jessee3/function_generator_scope_board/README.md

## 3D View
