jessee3/function_generator_scope_board/Mixed Signal Oscilloscope and Signal Generator Board.kicad_pcb

## KiCad design Mixed Signal Oscilloscope and Signal Generator Board.kicad_pcb (2025-03-13)

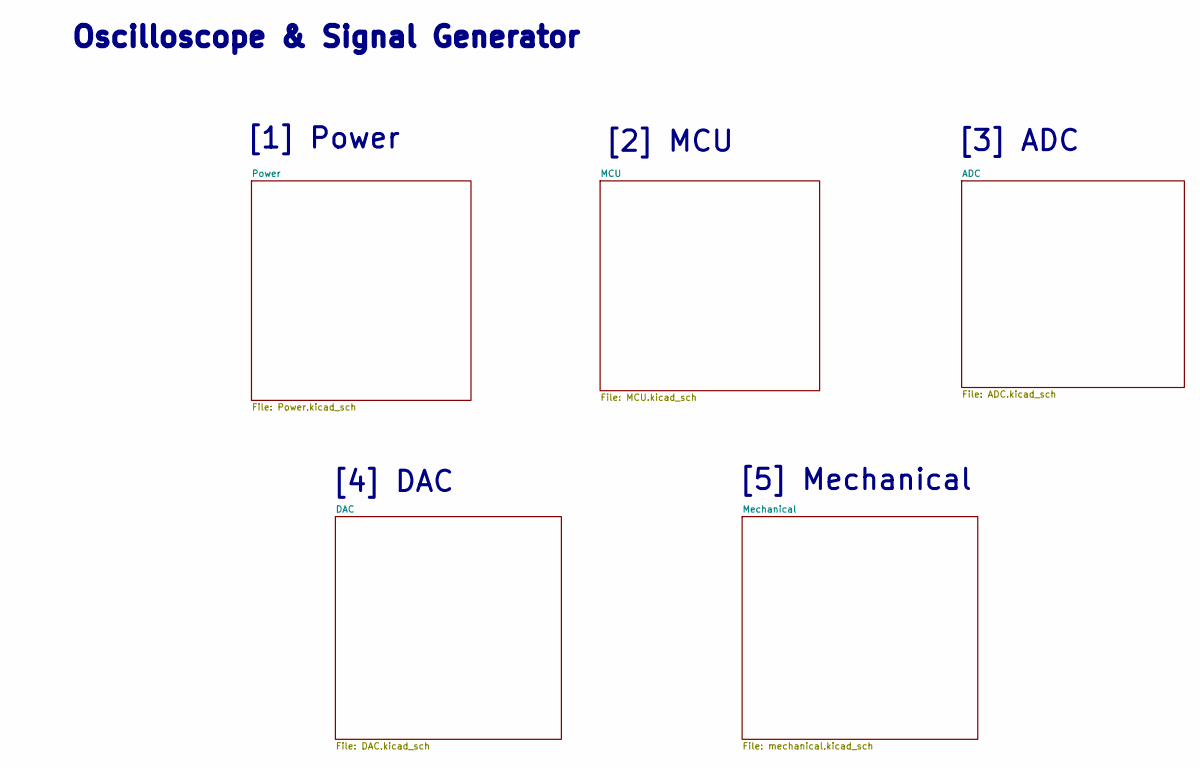
[picture p1: schematic Mixed Signal Oscilloscope and Signal Generator Board.kicad_sch, Oscilloscope & Signal Generator]

Notes on the sheet:
[1] Power
[3] ADC
Oscilloscope & Signal Generator
[4] DAC
[2] MCU
[5] Mechanical

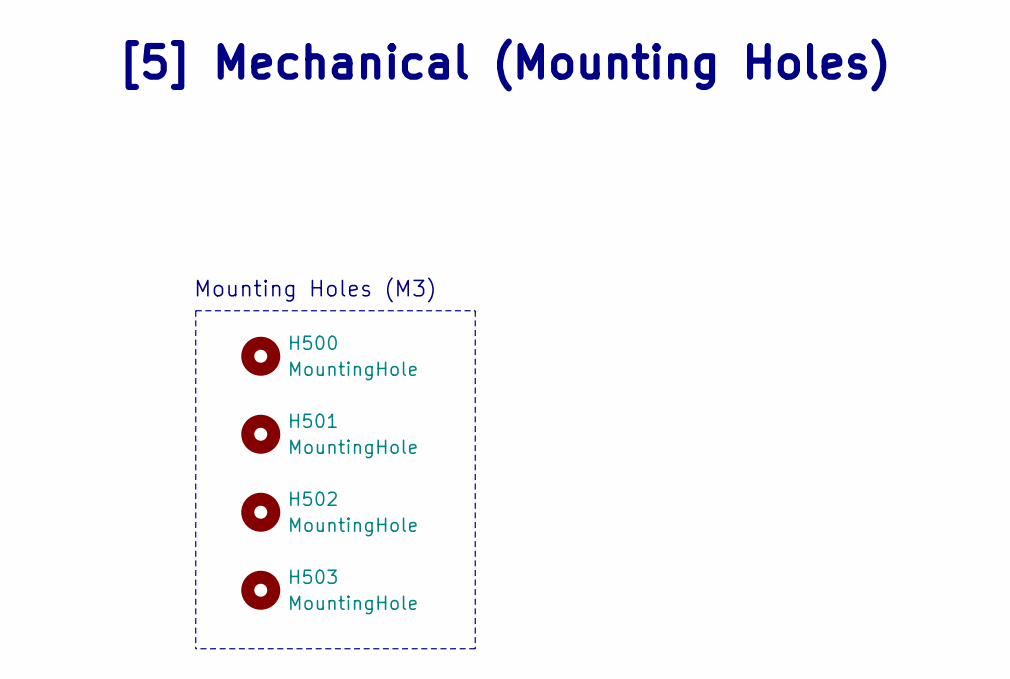
[picture p2: schematic mechanical.kicad_sch]

Parts:
H500, H501, H502, H503: MountingHole; MountingHole_3.2mm_M3

Notes on the sheet:
Mounting Holes (M3)
[5] Mechanical (Mounting Holes)

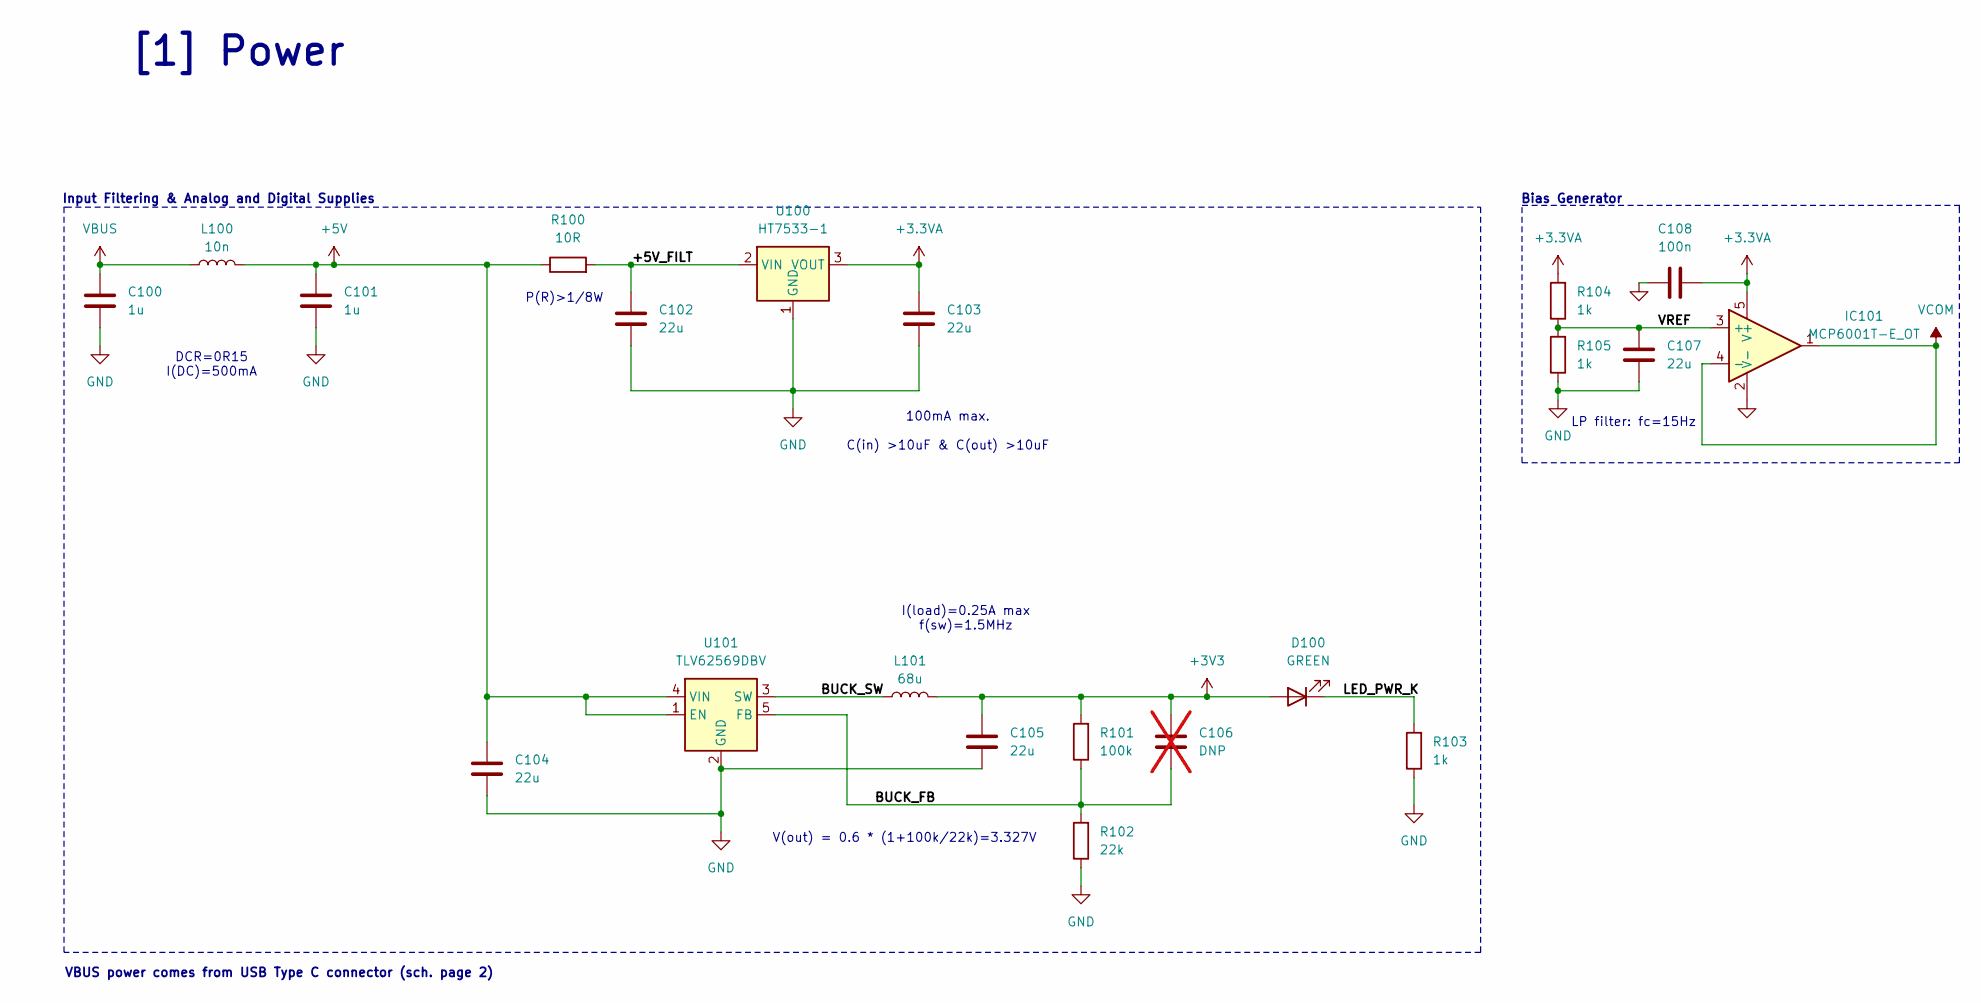
[picture p3: schematic Power.kicad_sch, Oscilloscope & Signal Generator]

Parts:
C100, C101: 1u; C_0603_1608Metric; Manufacturer_Part_Number CL10A105KO8NNNC; LCSC Part Number C1592
C102, C103, C104, C105, C107: 22u; C_0805_2012Metric; Manufacturer_Part_Number CL21A226MAQNNNE; LCSC Part Number C45783
C106: DNP; C_0402_1005Metric; not fitted
C108: 100n; C_0402_1005Metric; Manufacturer_Part_Number CL05B104KO5NNNC; LCSC Part Number C1525
D100: GREEN; LED_0603_1608Metric; Manufacturer_Part_Number LTST-C191KGKT; LCSC Part Number C125098
IC101: MCP6001T-E_OT; SOT95P270X145-5N; Manufacturer_Part_Number MCP6001T-E/OT; LCSC Part Number C29429
L100: 10n; L_0402_1005Metric; Manufacturer_Part_Number LQG15HS10NJ02D; LCSC Part Number C77103
L101: 68u; MWSA0603S; Manufacturer_Part_Number MWSA0603S-100MT
R100: 10R; R_0805_2012Metric; Manufacturer_Part_Number RC0805FR-0710RL; LCSC Part Number C96347
R101: 100k; R_0402_1005Metric; Manufacturer_Part_Number RC0402FR-07100KL; LCSC Part Number C60491
R102: 22k; R_0402_1005Metric; Manufacturer_Part_Number AECR0402F22K0K9; LCSC Part Number C328311
R103, R104, R105: 1k; R_0402_1005Metric; Manufacturer_Part_Number RC0402FR-071KL; LCSC Part Number C106235
U100: HT7533-1; SOT-89-3; Manufacturer_Part_Number HT7533-1; LCSC Part Number C5451672
U101: TLV62569DBV; SOT-23-5; Manufacturer_Part_Number TLV62569DBVR; LCSC Part Number C141836

Connections:
+3.3VA: C103.1, C108.2, IC101.5 (V+), R104.2, U100.3 (VOUT); also elsewhere on the board
+3V3: C105.1, C106.1, D100.2 (A), L101.2, R101.2; also elsewhere on the board
+5V: C101.1, C104.1, L100.2, R100.1, U101.1 (EN), U101.4 (VIN); also elsewhere on the board
/Power/+5V_FILT: C102.1, R100.2, U100.2 (VIN)
/Power/BUCK_FB: C106.2, R101.1, R102.2, U101.5 (FB)
/Power/BUCK_SW: L101.1, U101.3 (SW)
/Power/LED_PWR_K: D100.1 (K), R103.2
/Power/VREF: C107.1, IC101.3 (+), R104.1, R105.2
GND: C100.2, C101.2, C102.2, C103.2, C104.2, C105.2, C107.2, C108.1, IC101.2 (V-), R102.1, R103.1, R105.1, U100.1 (GND), U101.2 (GND); also elsewhere on the board
VBUS: C100.1, L100.1; also elsewhere on the board
VCOM: IC101.1, IC101.4 (-); also elsewhere on the board

Notes on the sheet:
Bias Generator
V(out) = 0.6 * (1+100k/22k)=3.327V
P(R)>1/8W
100mA max. C(in) >10uF & C(out) >10uF
Input Filtering & Analog and Digital Supplies
VBUS power comes from USB Type C connector (sch. page 2)
DCR=0R15 I(DC)=500mA
I(load)=0.25A max f(sw)=1.5MHz
LP filter: fc=15Hz
[1] Power

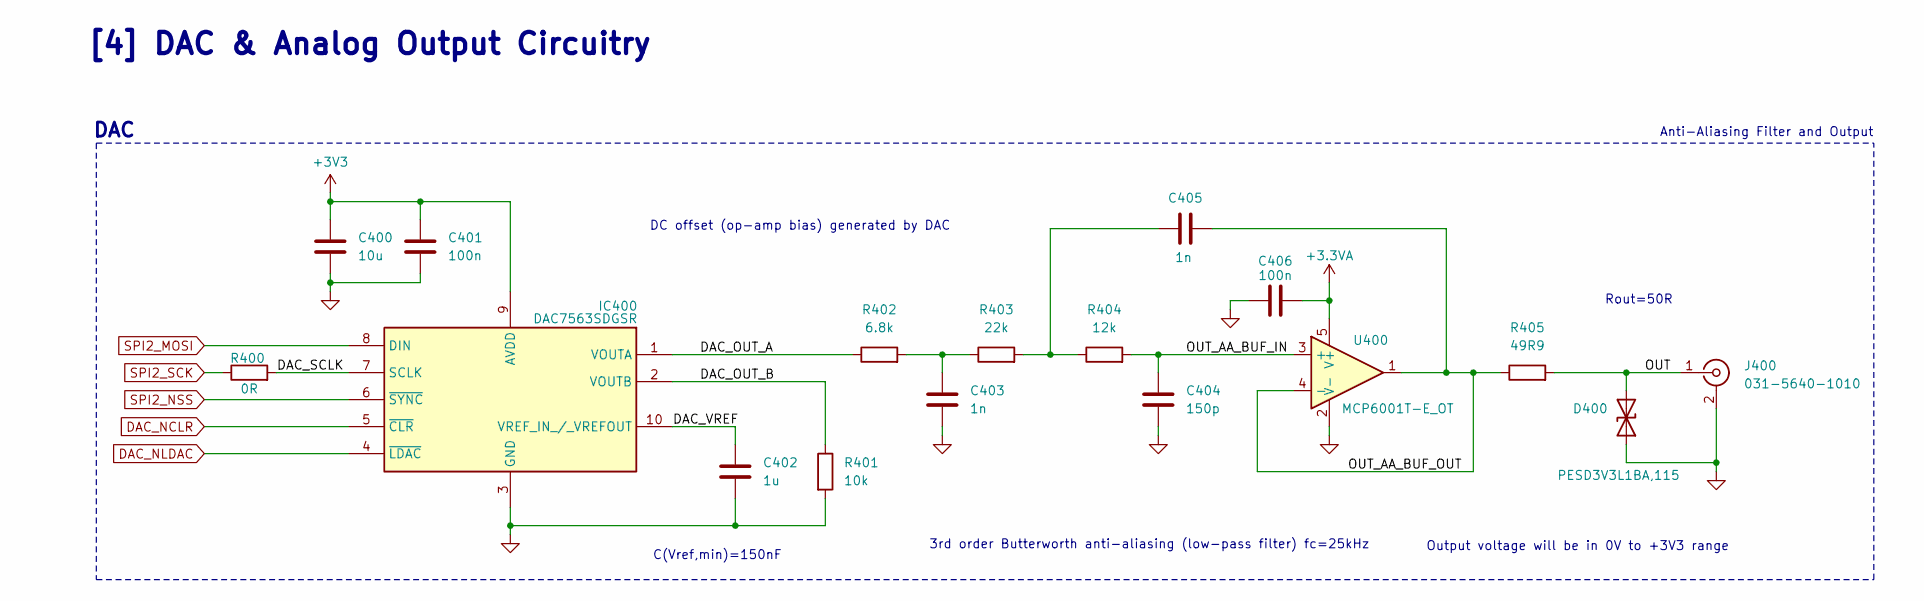
[picture p4: schematic DAC.kicad_sch, Oscilloscope & Signal Generator]

Parts:
C400: 10u; C_0603_1608Metric; Manufacturer_Part_Number CL10A106MQ8NNNC; LCSC Part Number C1691
C401, C406: 100n; C_0402_1005Metric; Manufacturer_Part_Number CL05B104KO5NNNC; LCSC Part Number C1525
C402: 1u; C_0603_1608Metric; Manufacturer_Part_Number CL10A105KO8NNNC; LCSC Part Number C1592
C403, C405: 1n; C_0402_1005Metric; Manufacturer_Part_Number CL05B102KB5NNNC; LCSC Part Number C14442
C404: 150p; C_0402_1005Metric; Manufacturer_Part_Number CL05C151JB51PNC; LCSC Part Number C472448
D400: PESD3V3L1BA,115; SOD2512X110N; Manufacturer_Part_Number PESD3V3L1BA,115; LCSC Part Number C51450
IC400: DAC7563SDGSR; SOP50P490X110-10N; Manufacturer_Part_Number DAC7563SDGSR; LCSC Part Number C601656
J400: 031-5640-1010; AMPHENOL-BNC-031-5640-1010; Manufacturer_Part_Number 31-5640-1010; LCSC Part Number C6997605
R400: 0R; R_0402_1005Metric; Manufacturer_Part_Number RC0402FR-070RL; LCSC Part Number C106231
R401: 10k; R_0402_1005Metric; Manufacturer_Part_Number RC0402FR-0710KL; LCSC Part Number C60490
R402: 6.8k; R_0402_1005Metric; Manufacturer_Part_Number RC0402JR-076K8L; LCSC Part Number C137847
R403: 22k; R_0402_1005Metric; Manufacturer_Part_Number AECR0402F22K0K9; LCSC Part Number C328311
R404: 12k; R_0402_1005Metric; Manufacturer_Part_Number FRC0402J123 TS; LCSC Part Number C2906889
R405: 49R9; R_0402_1005Metric; Manufacturer_Part_Number RC0402FR-0749R9L; LCSC Part Number C87044
U400: MCP6001T-E_OT; SOT95P270X145-5N; Manufacturer_Part_Number MCP6001T-E/OT; LCSC Part Number C29429

Connections:
+3.3VA: C406.2, U400.5 (V+); also elsewhere on the board
+3V3: C400.1, C401.1, IC400.9 (AVDD); also elsewhere on the board
/DAC/DAC_OUT_A: IC400.1 (VOUTA), R402.1
/DAC/DAC_OUT_B: IC400.2 (VOUTB), R401.1
/DAC/DAC_SCLK: IC400.7 (SCLK), R400.2
/DAC/DAC_VREF: C402.1, IC400.10 (VREF_IN_/_VREFOUT)
/DAC/OUT: D400.2 (A2), J400.1 (In), R405.2
/DAC/OUT_AA_BUF_IN: C404.1, R404.2, U400.3 (+)
/DAC/OUT_AA_BUF_OUT: C405.2, R405.1, U400.1, U400.4 (-)
DAC_NCLR: IC400.5 (~CLR); also elsewhere on the board
DAC_NLDAC: IC400.4 (~LDAC); also elsewhere on the board
GND: C400.2, C401.2, C402.2, C403.2, C404.2, C406.1, D400.1 (A1), IC400.3 (GND), J400.2 (Ext), R401.2, U400.2 (V-); also elsewhere on the board
unnamed: C403.1, R402.2, R403.1
unnamed: C405.1, R403.2, R404.1
SPI2_MOSI: IC400.8 (DIN); also elsewhere on the board
SPI2_NSS: IC400.6 (~SYNC); also elsewhere on the board
SPI2_SCK: R400.1; also elsewhere on the board

Notes on the sheet:
3rd order Butterworth anti-aliasing (low-pass filter) fc=25kHz
C(Vref,min)=150nF
Output voltage will be in 0V to +3V3 range
[4] DAC & Analog Output Circuitry
Rout=50R
DAC
Anti-Aliasing Filter and Output
DC offset (op-amp bias) generated by DAC

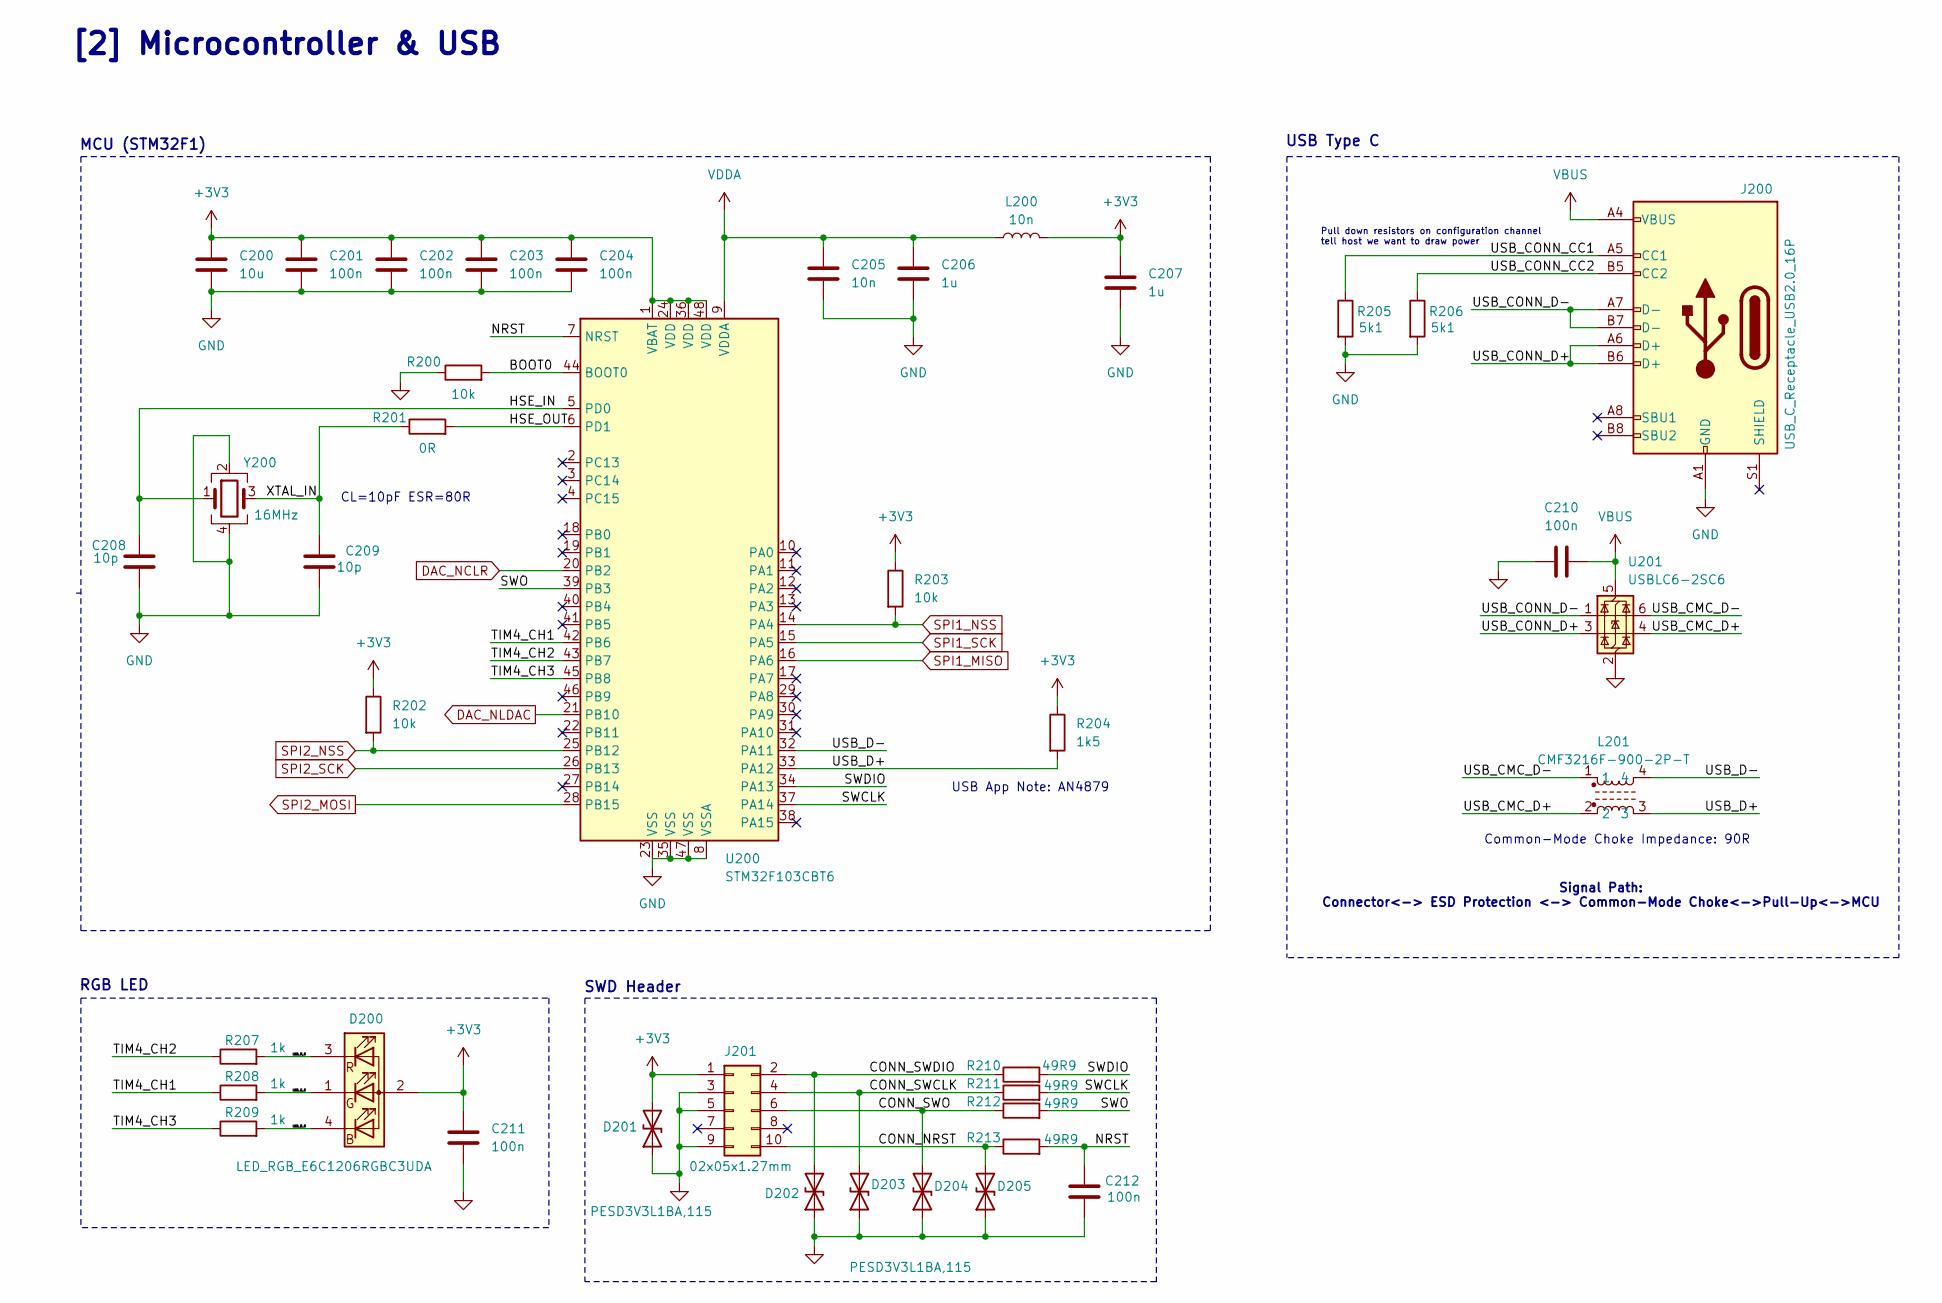
[picture p5: schematic MCU.kicad_sch, Oscilloscope & Signal Generator]

Parts:
C200: 10u; C_0603_1608Metric; Manufacturer_Part_Number CL10A106MQ8NNNC; LCSC Part Number C1691
C201, C202, C203, C204, C210, C211, C212: 100n; C_0402_1005Metric; Manufacturer_Part_Number CL05B104KO5NNNC; LCSC Part Number C1525
C205: 10n; C_0402_1005Metric; Manufacturer_Part_Number CL05B103KB5NNNC; LCSC Part Number C15195
C206, C207: 1u; C_0603_1608Metric; Manufacturer_Part_Number CL10A105KO8NNNC; LCSC Part Number C1592
C208, C209: 10p; C_0402_1005Metric; Manufacturer_Part_Number CL05C100JB5NNNC; LCSC Part Number C32949
D200: LED_RGB_E6C1206RGBC3UDA; E6C1206RGBC3UDA; Manufacturer_Part_Number E6C1206RGBC3UDA; LCSC Part Number C375571
D201, D202, D203, D204, D205: PESD3V3L1BA,115; SOD2512X110N; Manufacturer_Part_Number PESD3V3L1BA,115; LCSC Part Number C51450
J200: USB_C_Receptacle_USB2.0_16P; USB_C_Receptacle_HRO_TYPE-C-31-M-12; Manufacturer_Part_Number TYPEC-304A-ACP16G; LCSC Part Number C2909608
J201: 02x05x1.27mm; PinHeader_2x05_P1.27mm_Vertical_SMD; Manufacturer_Part_Number ZX-PZ1.27-2-5PZZ; LCSC Part Number C7501289
L200: 10n; L_0402_1005Metric; Manufacturer_Part_Number LQG15HS10NJ02D; LCSC Part Number C77103
L201: CMF3216F-900-2P-T; CMC-1206; Manufacturer_Part_Number CMF3216F-900-2P-T; LCSC Part Number C963740
R200, R202, R203: 10k; R_0402_1005Metric; Manufacturer_Part_Number RC0402FR-0710KL; LCSC Part Number C60490
R201: 0R; R_0402_1005Metric; Manufacturer_Part_Number RC0402FR-070RL; LCSC Part Number C106231
R204: 1k5; R_0402_1005Metric; Manufacturer_Part_Number AS02FTE1501; LCSC Part Number C409724
R205, R206: 5k1; R_0402_1005Metric; Manufacturer_Part_Number CR-02FL6---5K1; LCSC Part Number C409700
R207, R208, R209: 1k; R_0402_1005Metric; Manufacturer_Part_Number RC0402FR-071KL; LCSC Part Number C106235
R210, R211, R212, R213: 49R9; R_0402_1005Metric; Manufacturer_Part_Number RC0402FR-0749R9L; LCSC Part Number C87044
U200: STM32F103CBT6; LQFP-48_7x7mm_P0.5mm; Manufacturer_Part_Number STM32F103CBT6; LCSC Part Number C8304
U201: USBLC6-2SC6; SOT-23-6; Manufacturer_Part_Number USBLC6-2SC6; LCSC Part Number C7519
Y200: 16MHz; Crystal_SMD_3225-4Pin_3.2x2.5mm; Manufacturer_Part_Number HY16MSMD3225DB1R30; LCSC Part Number SMD3225-4P

Connections:
+3V3: C200.1, C201.1, C202.1, C203.1, C204.1, C207.1, C211.1, D200.2, D201.2 (A2), J201.1, L200.2, R202.1, R203.1, R204.1, U200.1 (VBAT), U200.24 (VDD), U200.36 (VDD), U200.48 (VDD); also elsewhere on the board
/MCU/BOOT0: R200.2, U200.44 (BOOT0)
/MCU/CONN_NRST: D205.2 (A2), J201.10, R213.1
/MCU/CONN_SWCLK: D203.2 (A2), J201.4, R211.1
/MCU/CONN_SWDIO: D202.2 (A2), J201.2, R210.1
/MCU/CONN_SWO: D204.2 (A2), J201.6, R212.1
/MCU/HSE_IN: C208.1, U200.5 (PD0), Y200.1
/MCU/HSE_OUT: R201.2, U200.6 (PD1)
/MCU/LED_B_K: D200.4, R209.2
/MCU/LED_G_K: D200.1, R208.2
/MCU/LED_R_K: D200.3, R207.2
/MCU/NRST: C212.2, R213.2, U200.7 (NRST)
/MCU/SWCLK: R211.2, U200.37 (PA14)
/MCU/SWDIO: R210.2, U200.34 (PA13)
/MCU/SWO: R212.2, U200.39 (PB3)
/MCU/TIM4_CH1: R208.1, U200.42 (PB6)
/MCU/TIM4_CH2: R207.1, U200.43 (PB7)
/MCU/TIM4_CH3: R209.1, U200.45 (PB8)
/MCU/USB_CMC_D+: L201.2, U201.4 (I/O2)
/MCU/USB_CMC_D-: L201.1, U201.6 (I/O1)
/MCU/USB_CONN_CC1: J200.A5 (CC1), R205.1
/MCU/USB_CONN_CC2: J200.B5 (CC2), R206.1
/MCU/USB_CONN_D+: J200.A6 (D+), J200.B6 (D+), U201.3 (I/O2)
/MCU/USB_CONN_D-: J200.A7 (D-), J200.B7 (D-), U201.1 (I/O1)
/MCU/USB_D+: L201.3, R204.2, U200.33 (PA12)
/MCU/USB_D-: L201.4, U200.32 (PA11)
/MCU/XTAL_IN: C209.1, R201.1, Y200.3
DAC_NCLR: U200.20 (PB2); also elsewhere on the board
DAC_NLDAC: U200.21 (PB10); also elsewhere on the board
GND: C200.2, C201.2, C202.2, C203.2, C204.2, C205.2, C206.2, C207.2, C208.2, C209.2, C210.1, C211.2, C212.1, D201.1 (A1), D202.1 (A1), D203.1 (A1), D204.1 (A1), D205.1 (A1), J200.A1 (GND), J200.A12 (GND), J200.B1 (GND), J200.B12 (GND), J201.3, J201.5, J201.9, R200.1, R205.2, R206.2, U200.8 (VSSA), U200.23 (VSS), U200.35 (VSS), U200.47 (VSS), U201.2 (GND), Y200.2, Y200.4; also elsewhere on the board
SPI1_MISO: U200.16 (PA6); also elsewhere on the board
SPI1_NSS: R203.2, U200.14 (PA4); also elsewhere on the board
SPI1_SCK: U200.15 (PA5); also elsewhere on the board
SPI2_MOSI: U200.28 (PB15); also elsewhere on the board
SPI2_NSS: R202.2, U200.25 (PB12); also elsewhere on the board
SPI2_SCK: U200.26 (PB13); also elsewhere on the board
VBUS: C210.2, J200.A4 (VBUS), J200.A9 (VBUS), J200.B4 (VBUS), J200.B9 (VBUS), U201.5 (VBUS); also elsewhere on the board
VDDA: C205.1, C206.1, L200.1, U200.9 (VDDA)

Notes on the sheet:
USB Type C
USB App Note: AN4879
[2] Microcontroller & USB
RGB LED
Signal Path: Connector<-> ESD Protection <-> Common-Mode Choke<->Pull-Up<->MCU
CL=10pF ESR=80R
MCU (STM32F1)
Pull down resistors on configuration channel tell host we want to draw power
Common-Mode Choke Impedance: 90R
SWD Header

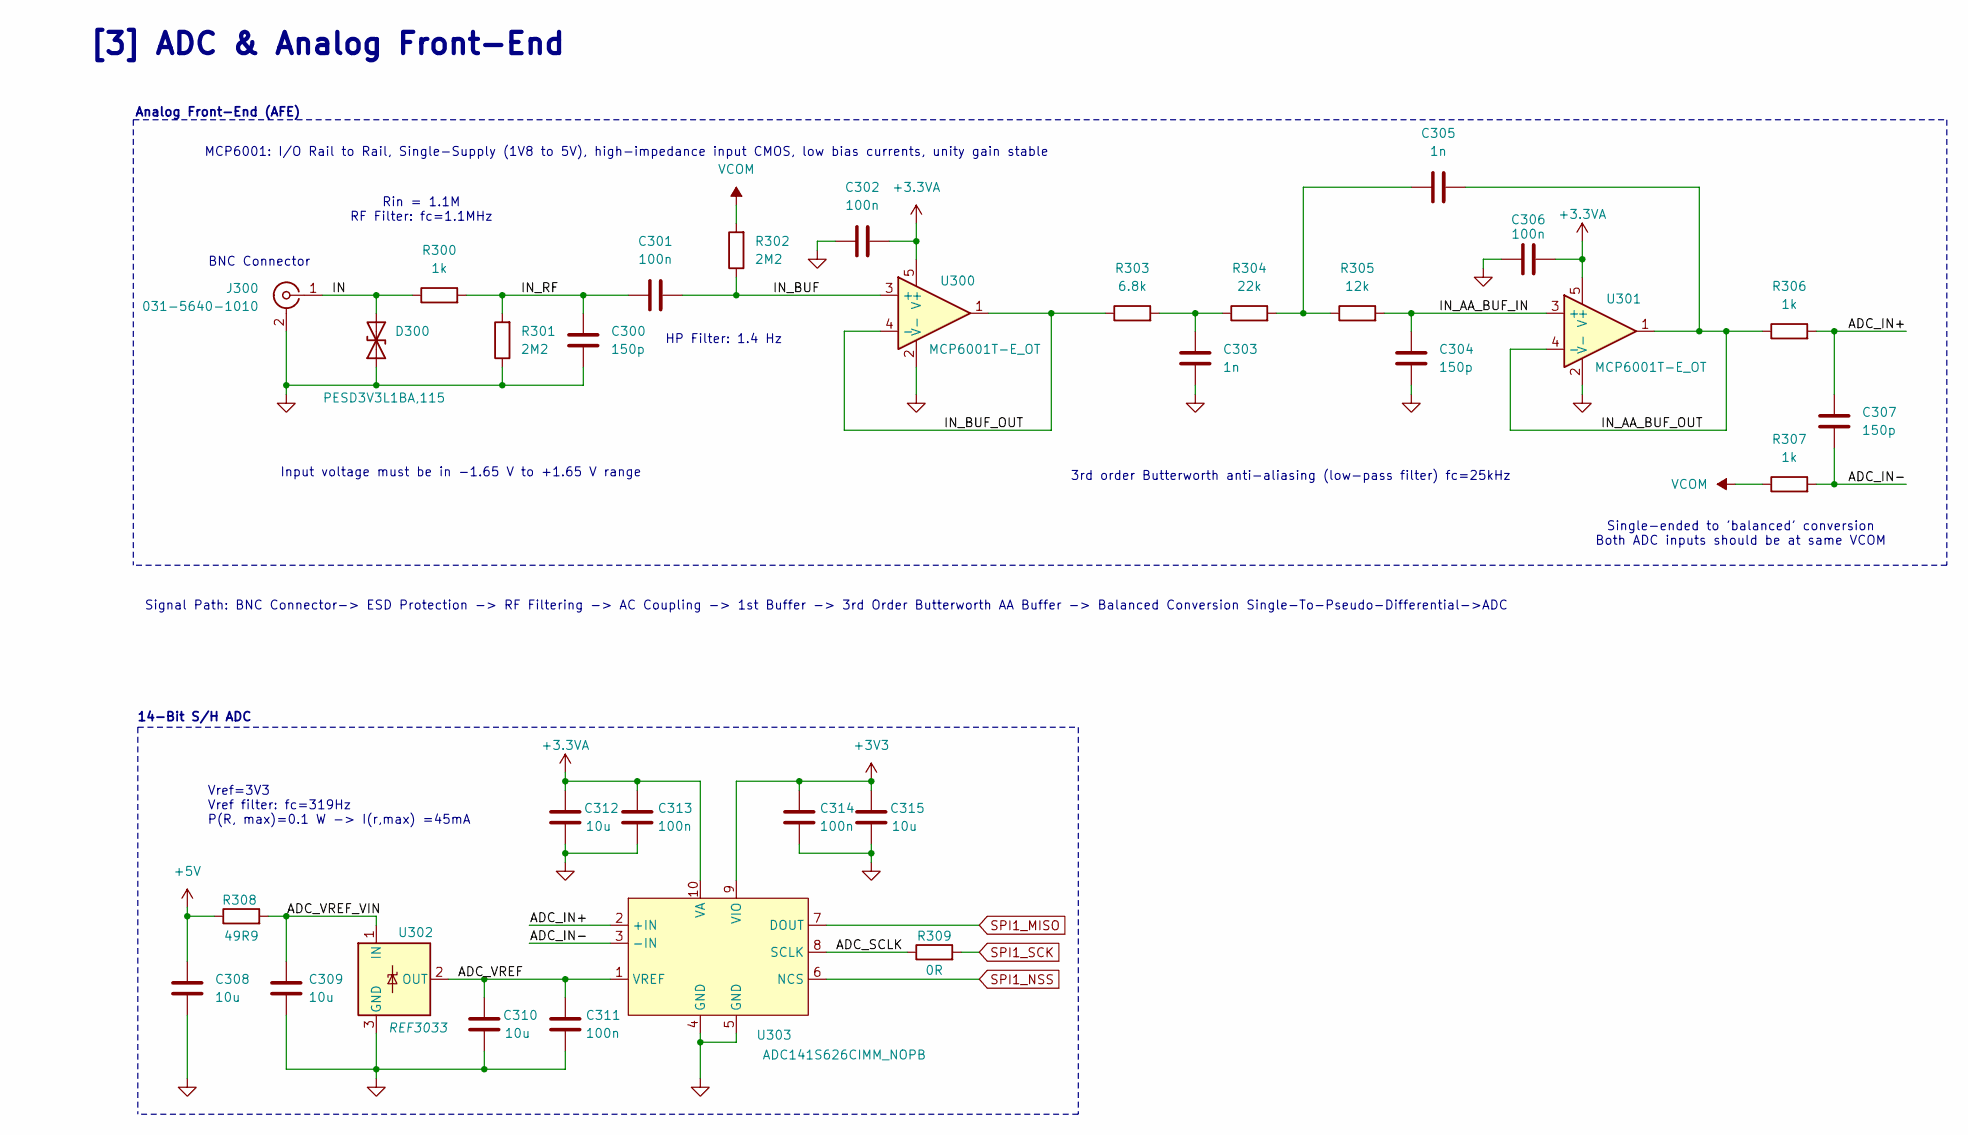
[picture p6: schematic ADC.kicad_sch, Oscilloscope & Signal Generator]

Parts:
C300, C304, C307: 150p; C_0402_1005Metric; Manufacturer_Part_Number CL05C151JB51PNC; LCSC Part Number C472448
C301, C302, C306, C311, C313, C314: 100n; C_0402_1005Metric; Manufacturer_Part_Number CL05B104KO5NNNC; LCSC Part Number C1525
C303, C305: 1n; C_0402_1005Metric; Manufacturer_Part_Number CL05B102KB5NNNC; LCSC Part Number C14442
C308, C309, C310, C312, C315: 10u; C_0603_1608Metric; Manufacturer_Part_Number CL10A106MQ8NNNC; LCSC Part Number C1691
D300: PESD3V3L1BA,115; SOD2512X110N; Manufacturer_Part_Number PESD3V3L1BA,115; LCSC Part Number C51450
J300: 031-5640-1010; AMPHENOL-BNC-031-5640-1010; Manufacturer_Part_Number 31-5640-1010; LCSC Part Number C6997605
R300, R306, R307: 1k; R_0402_1005Metric; Manufacturer_Part_Number RC0402FR-071KL; LCSC Part Number C106235
R301, R302: 2M2; R_0402_1005Metric; Manufacturer_Part_Number RC0402JR-072M2L; LCSC Part Number C274901
R303: 6.8k; R_0402_1005Metric; Manufacturer_Part_Number RC0402JR-076K8L; LCSC Part Number C137847
R304: 22k; R_0402_1005Metric; Manufacturer_Part_Number AECR0402F22K0K9; LCSC Part Number C328311
R305: 12k; R_0402_1005Metric; Manufacturer_Part_Number FRC0402J123 TS; LCSC Part Number C2906889
R308: 49R9; R_0402_1005Metric; Manufacturer_Part_Number RC0402FR-0749R9L; LCSC Part Number C87044
R309: 0R; R_0402_1005Metric; Manufacturer_Part_Number RC0402FR-070RL; LCSC Part Number C106231
U300, U301: MCP6001T-E_OT; SOT95P270X145-5N; Manufacturer_Part_Number MCP6001T-E/OT; LCSC Part Number C29429
U302: REF3033; SOT-23; Manufacturer_Part_Number View marketplace suppliers’ inventory i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; LCSC Part Number C36658
U303: ADC141S626CIMM_NOPB; SOP50P490X110-10N; Manufacturer_Part_Number ADC141S626CIMMX/NOPB; LCSC Part Number C2861039

Connections:
+3.3VA: C302.2, C306.2, C312.1, C313.1, U300.5 (V+), U301.5 (V+), U303.10 (VA); also elsewhere on the board
+3V3: C314.1, C315.1, U303.9 (VIO); also elsewhere on the board
+5V: C308.1, R308.1; also elsewhere on the board
/ADC/ADC_IN+: C307.1, R306.2, U303.2 (+IN)
/ADC/ADC_IN-: C307.2, R307.2, U303.3 (-IN)
/ADC/ADC_SCLK: R309.1, U303.8 (SCLK)
/ADC/ADC_VREF: C310.1, C311.1, U302.2 (OUT), U303.1 (VREF)
/ADC/ADC_VREF_VIN: C309.1, R308.2, U302.1 (IN)
/ADC/IN: D300.2 (A2), J300.1 (In), R300.1
/ADC/IN_AA_BUF_IN: C304.1, R305.2, U301.3 (+)
/ADC/IN_AA_BUF_OUT: C305.2, R306.1, U301.1, U301.4 (-)
/ADC/IN_BUF: C301.2, R302.1, U300.3 (+)
/ADC/IN_BUF_OUT: R303.1, U300.1, U300.4 (-)
/ADC/IN_RF: C300.1, C301.1, R300.2, R301.2
GND: C300.2, C302.1, C303.2, C304.2, C306.1, C308.2, C309.2, C310.2, C311.2, C312.2, C313.2, C314.2, C315.2, D300.1 (A1), J300.2 (Ext), R301.1, U300.2 (V-), U301.2 (V-), U302.3 (GND), U303.4 (GND), U303.5 (GND); also elsewhere on the board
unnamed: C303.1, R303.2, R304.1
unnamed: C305.1, R304.2, R305.1
SPI1_MISO: U303.7 (DOUT); also elsewhere on the board
SPI1_NSS: U303.6 (NCS); also elsewhere on the board
SPI1_SCK: R309.2; also elsewhere on the board
VCOM: R302.2, R307.1; also elsewhere on the board

Notes on the sheet:
Analog Front-End (AFE)
Vref=3V3 Vref filter: fc=319Hz P(R, max)=0.1 W -> I(r,max) =45mA
[3] ADC & Analog Front-End
Rin = 1.1M RF Filter: fc=1.1MHz
Single-ended to 'balanced' conversion Both ADC inputs should be at same VCOM
HP Filter: 1.4 Hz
Signal Path: BNC Connector-> ESD Protection -> RF Filtering -> AC Coupling -> 1st Buffer -> 3rd Order Butterworth AA Buffer -> Balanced Conversion Single-To-Pseudo-Differential->ADC
3rd order Butterworth anti-aliasing (low-pass filter) fc=25kHz
14-Bit S/H ADC
BNC Connector
MCP6001: I/O Rail to Rail, Single-Supply (1V8 to 5V), high-impedance input CMOS, low bias currents, unity gain stable
Input voltage must be in -1.65 V to +1.65 V range

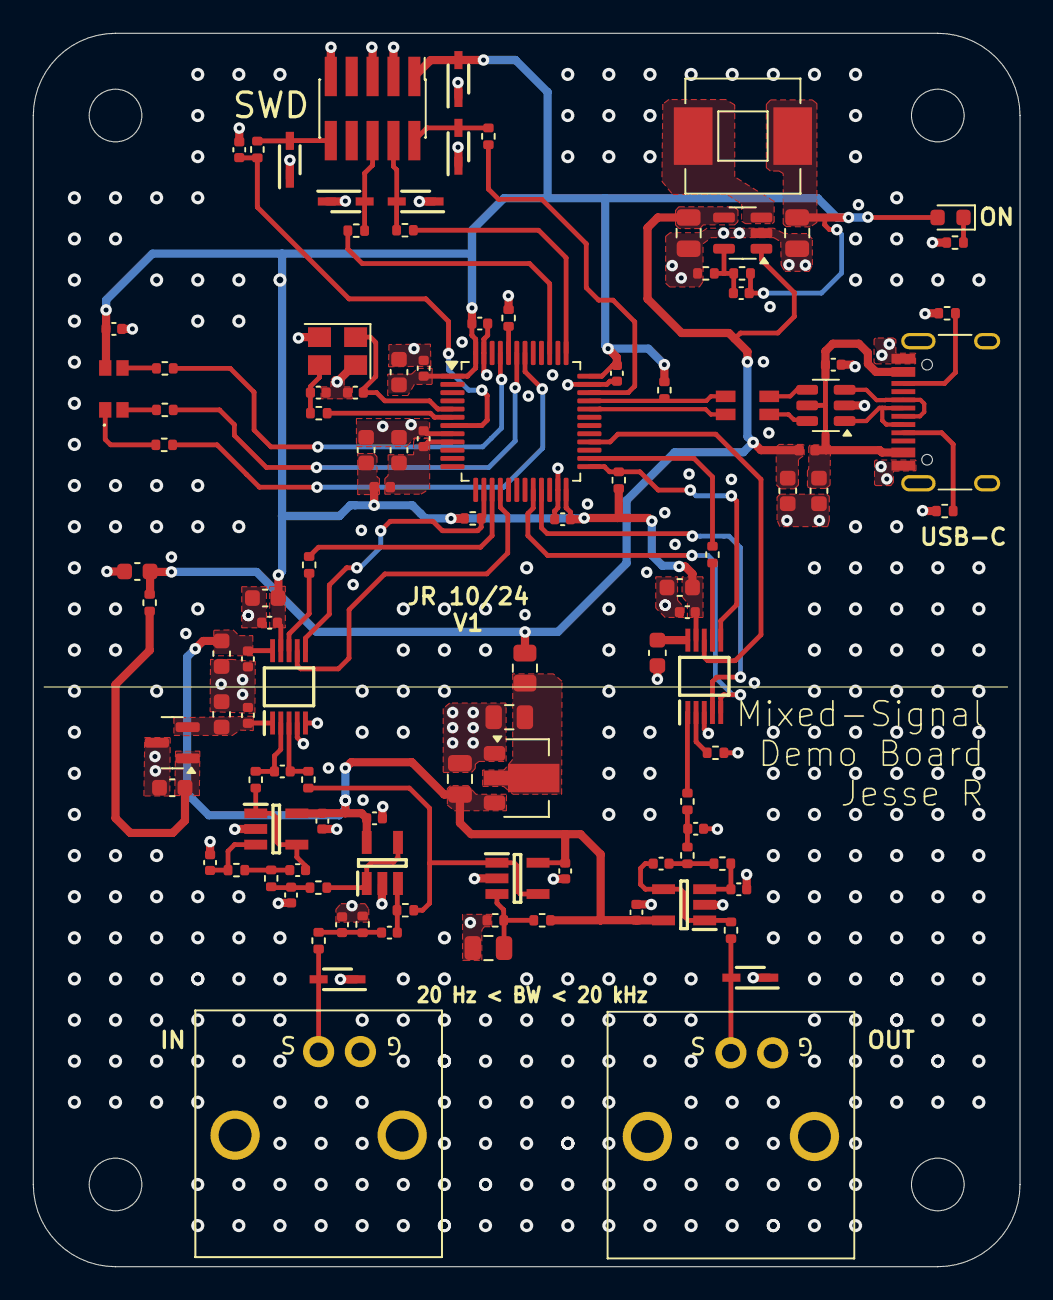
[picture p7: board Mixed Signal Oscilloscope and Signal Generator Board.kicad_pcb from above]

Board: 4 copper layers, 60.0 x 75.0 mm, 114 parts (0 on the bottom side), 68 nets.
